thatonearchguy/IDP-208/diagrams/boarddiagram.jpg

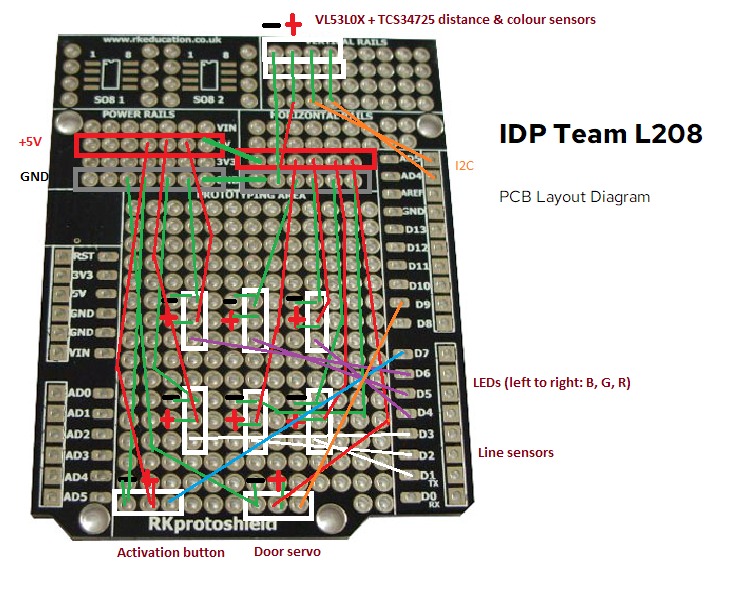
diagrams/boarddiagram.jpg
