thatonearchguy/IDP-208/(commit log)

2024-02-16 boiler plate for search algo
2024-02-16 Added PID line following interface for pathfinding
2024-02-18 merged pathfinding and added LED blinking and control
2024-02-20 tuned pid and ditched imu
2024-02-22 Updated rotation logic to use colour sensor
2024-02-22 servo motor function for door operation
2024-02-25 Pruned folders and added schematics
    [IDP.kicad_pcb, IDP.kicad_sch]
2024-02-28 Fixed bugs and adjusted calib params
    [main.cpp]
2024-02-28 Bug fixes, added bends as nodes
    [main.cpp, pathFinder.cpp, pathFinder.h]
2024-02-28 Bugfixes and optimised SRAM
    [calib.h, main.cpp]
2024-02-28 pruned dependencies and backed up wiring.c
2024-02-29 Prune deps, integrated crash sensor with PCICR interrupt
    [calib.h, main.cpp]
2024-03-01 fixed small bug, pruned deps and added edge flipping for more robust turns
    [calib.h, dec.h, main.cpp]
2024-03-07 Fixed calibration values
2024-03-07 Fixed bugs, refined recovery algorithm
    [calib.h, main.cpp]
